WilliamOpenshaw/split-keyboard-duotractyl/layout pictures/keymap image (1).png

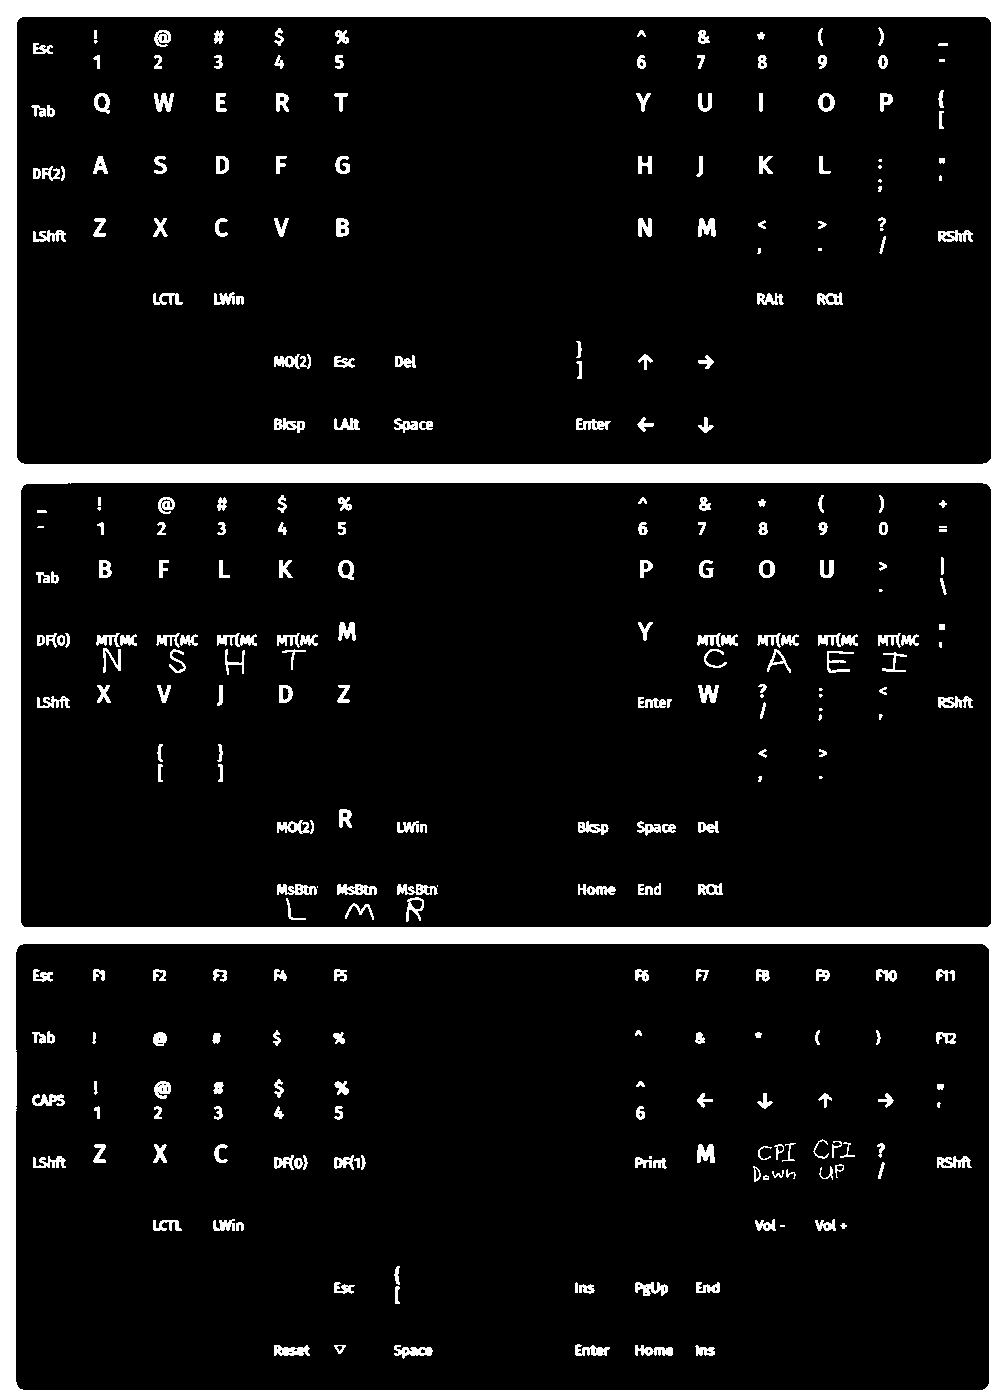
layout pictures/keymap image (1).png
