WilliamOpenshaw/split-keyboard-duotractyl/layout pictures/keymap image.png

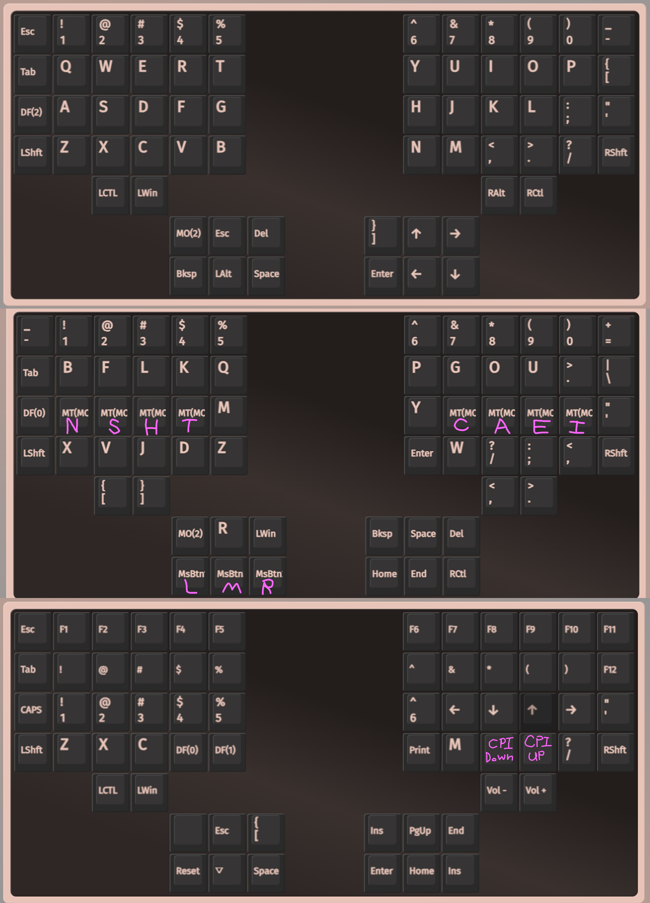
layout pictures/keymap image.png
