WilliamOpenshaw/split-keyboard-duotractyl/3d Models/Duotractyl 2-plateleft.stl

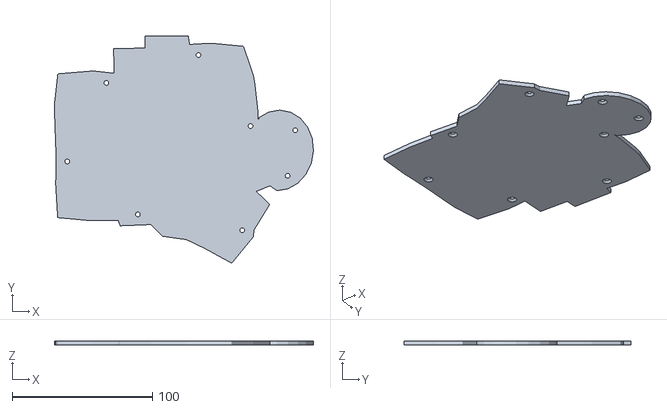
[picture p20: CAD file, 2026-11-06]
3d Models/Duotractyl 2-plateleft.stl
184.7 x 162.3 x 3.00
