WilliamOpenshaw/split-keyboard-duotractyl/3d Models/Duotractyl-holderright.stl

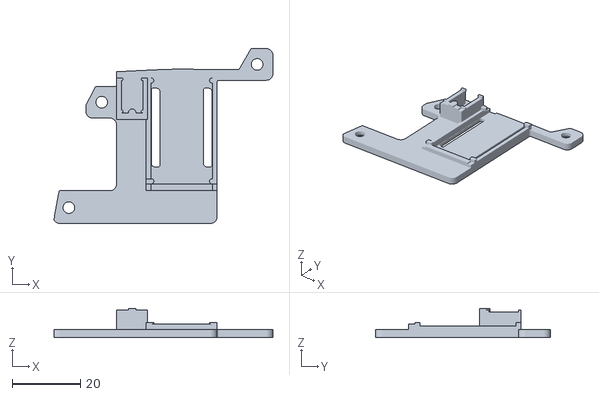
[picture p21: CAD file, 2026-11-06]
3d Models/Duotractyl-holderright.stl
64.1 x 51.2 x 8.50
