WilliamOpenshaw/split-keyboard-duotractyl/3d Models/Duotractyl-plateleft.stl

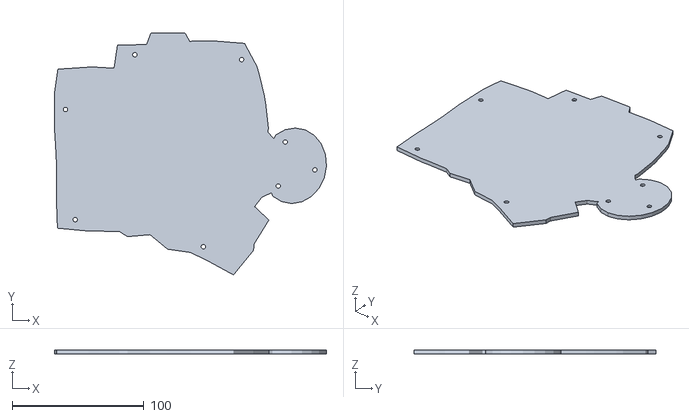
[picture p22: CAD file, 2026-11-06]
3d Models/Duotractyl-plateleft.stl
206.6 x 183.7 x 3.00
