WilliamOpenshaw/split-keyboard-duotractyl/3d Models/Duotractyl-caseright.stl

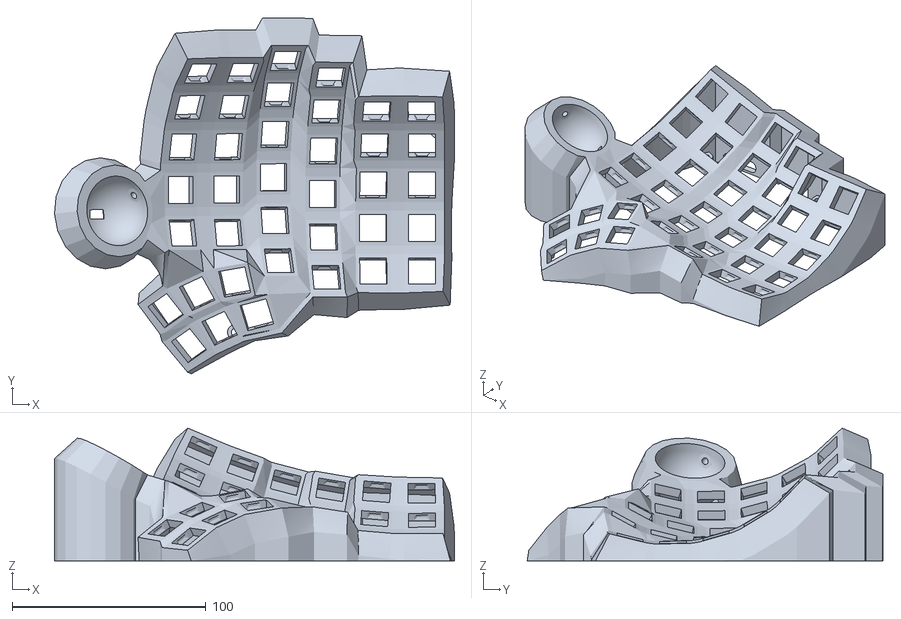
[picture p23: CAD file, 2026-11-06]
3d Models/Duotractyl-caseright.stl
206.6 x 183.7 x 68.6
