WilliamOpenshaw/split-keyboard-duotractyl/3d Models/Duotractyl 2-caseright.stl

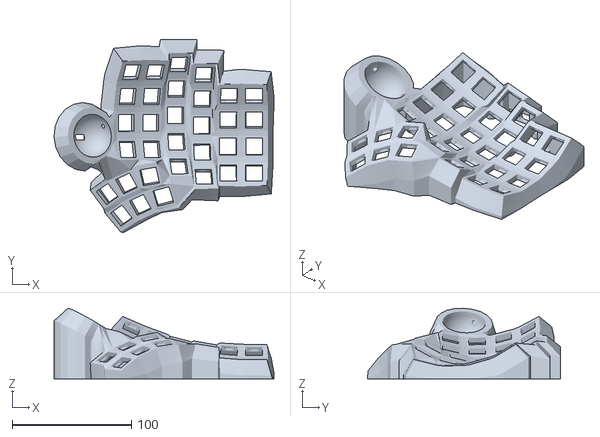
[picture p24: CAD file, 2026-11-06]
3d Models/Duotractyl 2-caseright.stl
184.7 x 162.3 x 59.2
