WilliamOpenshaw/split-keyboard-duotractyl/3d Models/Duotractyl 2-holderleft.stl

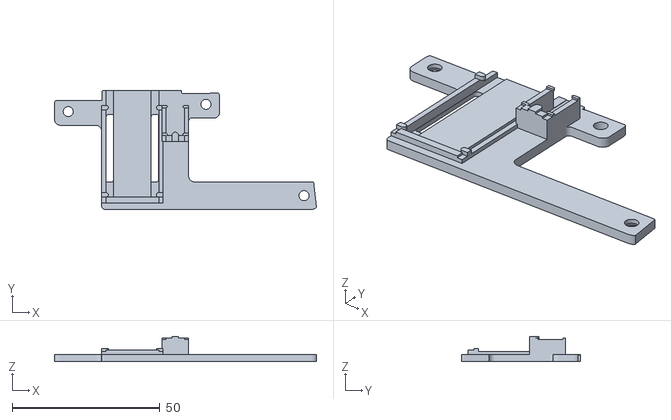
[picture p25: CAD file, 2026-11-06]
3d Models/Duotractyl 2-holderleft.stl
88.7 x 40.2 x 8.50
