WilliamOpenshaw/split-keyboard-duotractyl/(list of files, cad)

Other CAD files:
3d Models/Duotractyl 2-plateright.stl
3d Models/Duotractyl-holderleft.stl
3d Models/Duotractyl 2-caseleft.stl
3d Models/Duotractyl-plateright.stl
3d Models/Duotractyl 2-holderright.stl
3d Models/Duotractyl-caseleft.stl
3d Models/Duotractyl-caseleft (1).stl
