WilliamOpenshaw/split-keyboard-duotractyl/layout pictures/keymap print.png

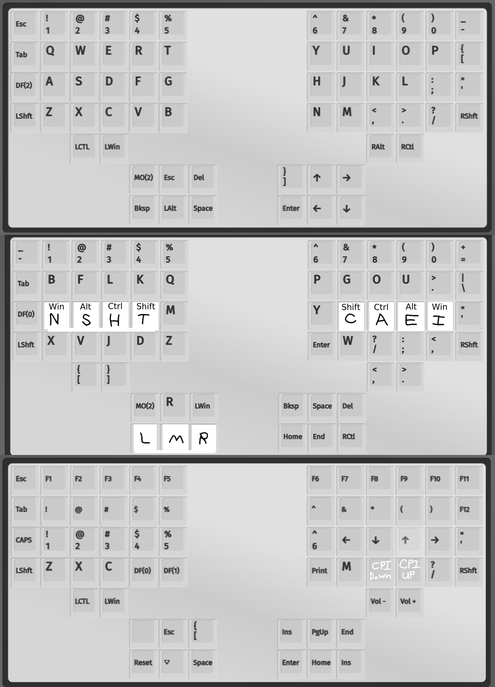
layout pictures/keymap print.png
