WilliamOpenshaw/split-keyboard-duotractyl/last working setup/2.1/duotractyl/config.h

#pragma once

#define VENDOR_ID       0x1209
#define PRODUCT_ID      0x5070
#define DEVICE_VER      0x0002
#define MANUFACTURER    "Cosmos"
#define PRODUCT         "DuoTractyl"

#define PMW33XX_CS_PIN GP10
#define PMW33XX_CPI 1600
#define ROTATIONAL_TRANSFORM_ANGLE 90
#define POINTING_DEVICE_INVERT_X

// Make sure this is before the QMK include
//#define MOUSE_SHARED_EP 1

//#include QMK_KEYBOARD_H

// Split keyboard configuration
#define EE_HANDS
#define MASTER_LEFT
#define SPLIT_USB_DETECT

// Serial communication configuration
#define SERIAL_USART_FULL_DUPLEX
#define SERIAL_USART_TX_PIN GP0
#define SERIAL_USART_RX_PIN GP1
#define SERIAL_USART_SPEED 460800

// Split transport features
#define SPLIT_POINTING_ENABLE
#define SPLIT_LAYER_STATE_ENABLE
#define SPLIT_MODS_ENABLE

// Configure both pointing devices
#define POINTING_DEVICE_COMBINED    // Combine reports from both sides

// SPI configuration for PMW3360 sensors
#define SPI_DRIVER SPID0
#define SPI_SCK_PIN GP18
#define SPI_MISO_PIN GP20
#define SPI_MOSI_PIN GP19

// PMW3360 sensor configuration for right side

// Pointing device settings
#define POINTING_DEVICE_TASK_THROTTLE_MS 10

// RP2040 bootloader configuration
#define RP2040_BOOTLOADER_DOUBLE_TAP_RESET
#define RP2040_BOOTLOADER_DOUBLE_TAP_RESET_LED GP17
